HIGHVOLTAGEBEE/BNO-EZ-Adapter/BNO-EZ-Adapter-Quick-Start.pptx

## GND SCL SDA +3.3V

BNO-EZ Adapter

Der BNO EZ-Adapter ist ein Adapter für den Adafruit BNO085-Kompasssensor, der die Kommunikation über einfache I²C-Register ermöglicht und so moderne Kompasstechnologie für ältere Fischertechnik-Controller nutzbar macht.

!

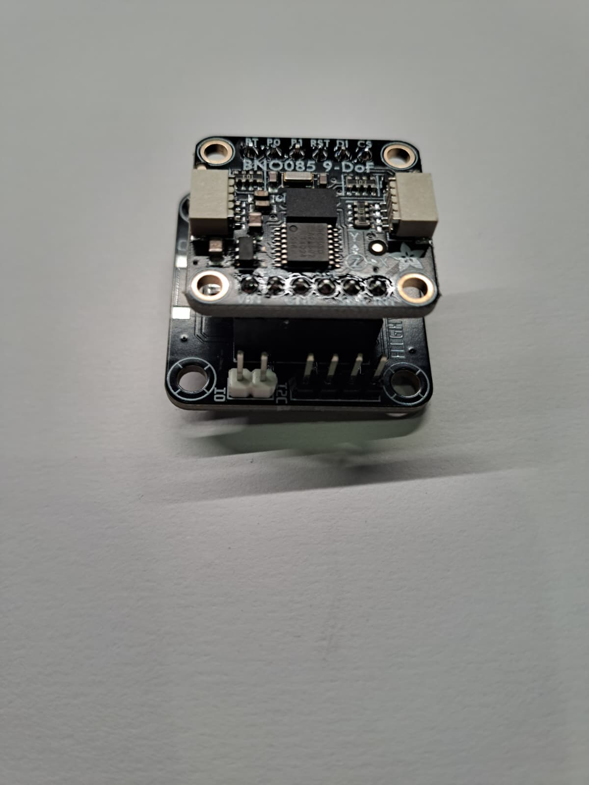
[picture p1: figure]
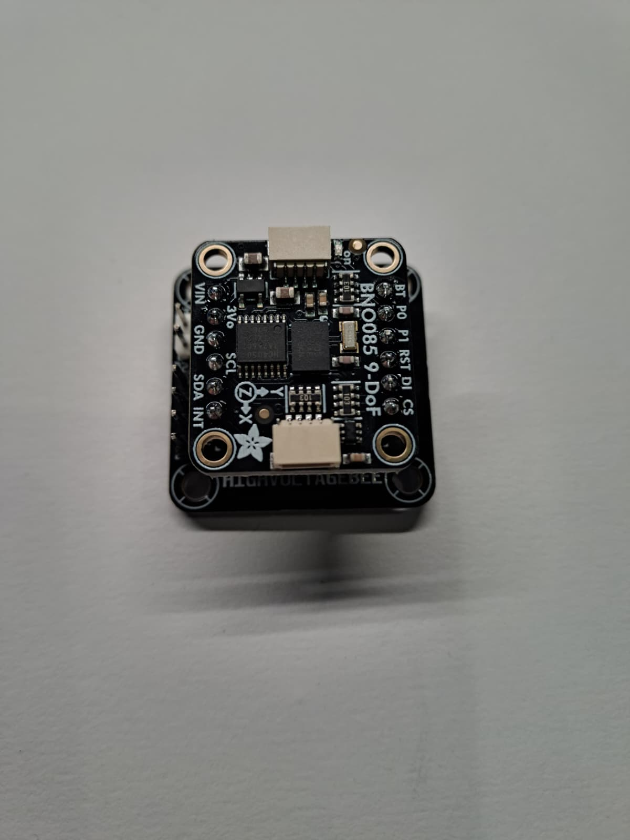
[picture p2: figure]

Wichtig: Adafruit BNO085 in richtiger Orientierung aufstecken!

USB-C

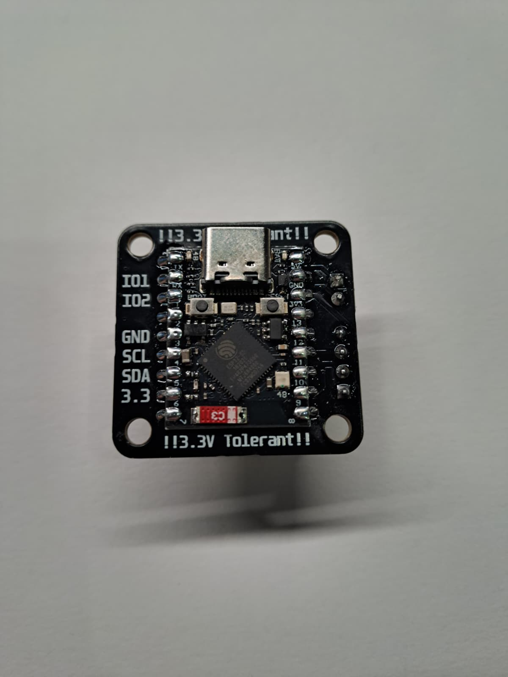
[picture p3: figure]

USB-C nur zum Testen oder zum Programmieren verwenden.

Wichtig: NUR 3.3V Tolerant nicht 5V und KEIN Verpolungsschutz!

IO2
IO1

Auslesen

Nullen

Über I²C auslesen:
Gerätadresse: 0x22
Richtungsregister: 0x0
Kompass Nullen: 0x10
Eine RGB LED ist unten auf der Platine wenn sie grün ist dann Sensor bereit.

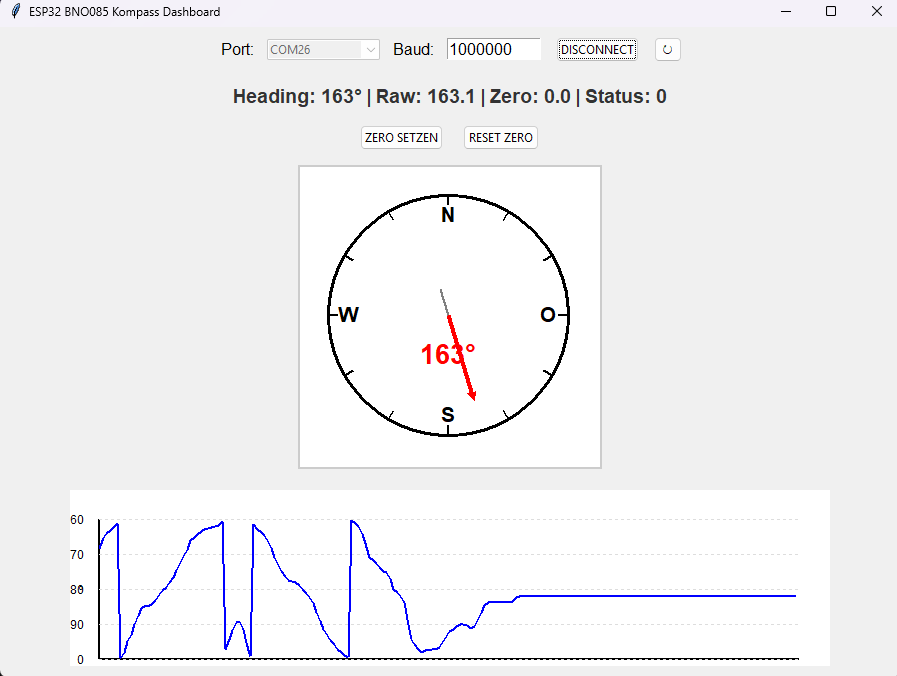
[picture p4: figure]
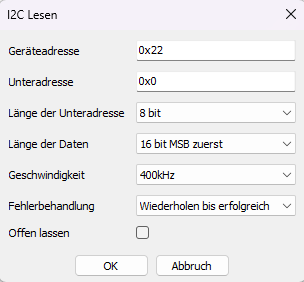
[picture p5: figure]
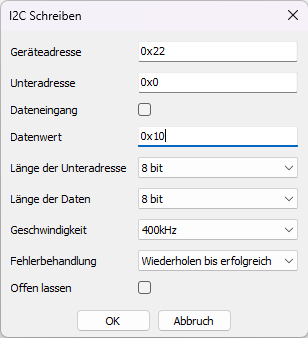
[picture p6: figure]

Programm um Sensor zu testen:
- Liest Werte aus
- Zeigt Fehler an
- Kompass extern Nullen
Einrichten:
- COM Port finden und auswählen
- Verbinden drücken
