HIGHVOLTAGEBEE/BNO-EZ-Adapter/BNO-EZ-Platine/bom.xlsx

No. | Quantity | Comment | Designator | Footprint | Value | Manufacturer Part | Manufacturer | Supplier Part | Supplier
1 | 1 | SM06B-SRSS-TB(LF)(SN) | COMBO | CONN-SMD_SM06B-SRSS-TB-LF-SN |  | SM06B-SRSS-TB(LF)(SN) | JST | C160405 | LCSC
2 | 1 | HDR-M_2.54_1x4P | I2C | HDR-TH_4P-P2.54-V-M
3 | 1 | HDR-M_2.54_1x2P | IO | HDR-TH_2P-P2.54-V-M-1
4 | 4 | Screw-Hole-M3 | SCREW1,SCREW2,SCREW3,SCREW4 | Screw-Hole-M3
5 | 2 | HX PM2.54-1x6P TP H8.5-YQ | U2,U3 | HDR-SMD_HX-PM2.54-1X6P-TP-H8.5-YQ |  | HX PM2.54-1x6P TP H8.5-YQ | hanxia(韩下) | C46635842 | LCSC
6 | 1 | ESP32-S3-Supermini | U5 | ESP32-S3-Supermini
