HIGHVOLTAGEBEE/BNO-EZ-Adapter/BNO-EZ-Platine/schaltplan.pdf

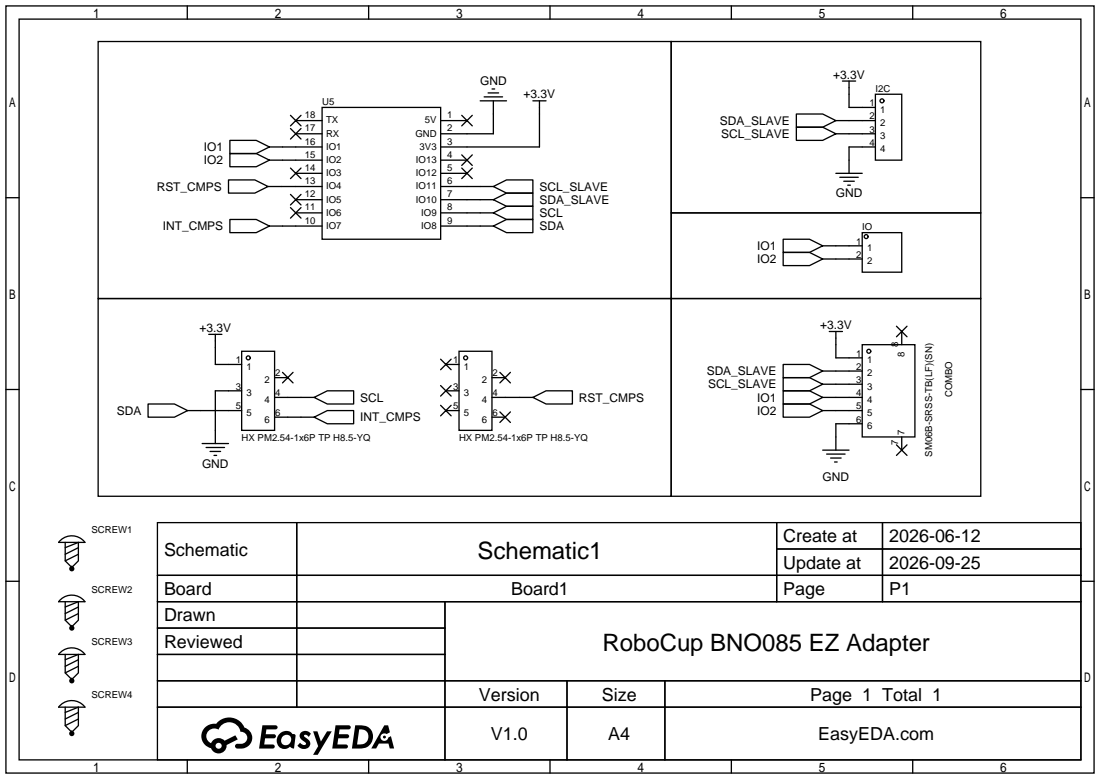
[picture p8: page 1]

SM06B-SRSS-TB(LF)(SN)

Schematic | Schematic1 | Create at | 2026-06-12

Update at | 2026-09-25

Board | Board1 | Page | P1
Drawn | | RoboCup BNO085 EZ Adapter
Reviewed

Version | Size | Page 1 Total 1
V1.0 | A4 | EasyEDA.com
